zenmai/portableSpcPlayer/portableSpcPlayer_schematic.png

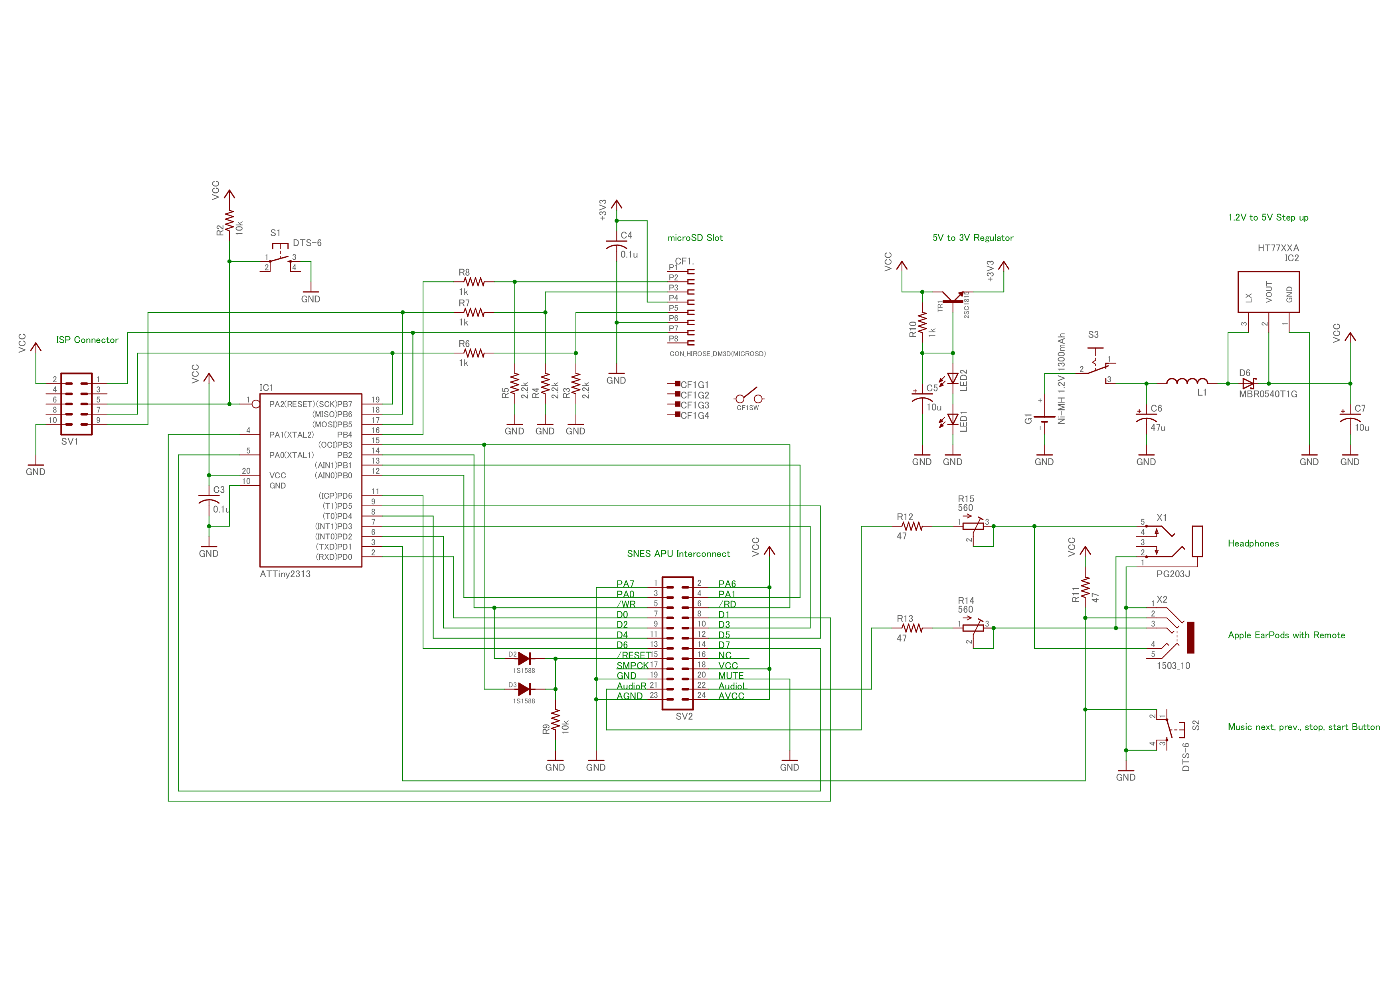
portableSpcPlayer_schematic.png
