zenmai/portableSpcPlayer/portableSpcPlayer.sch

## EAGLE design portableSpcPlayer.sch (2016-06-08)

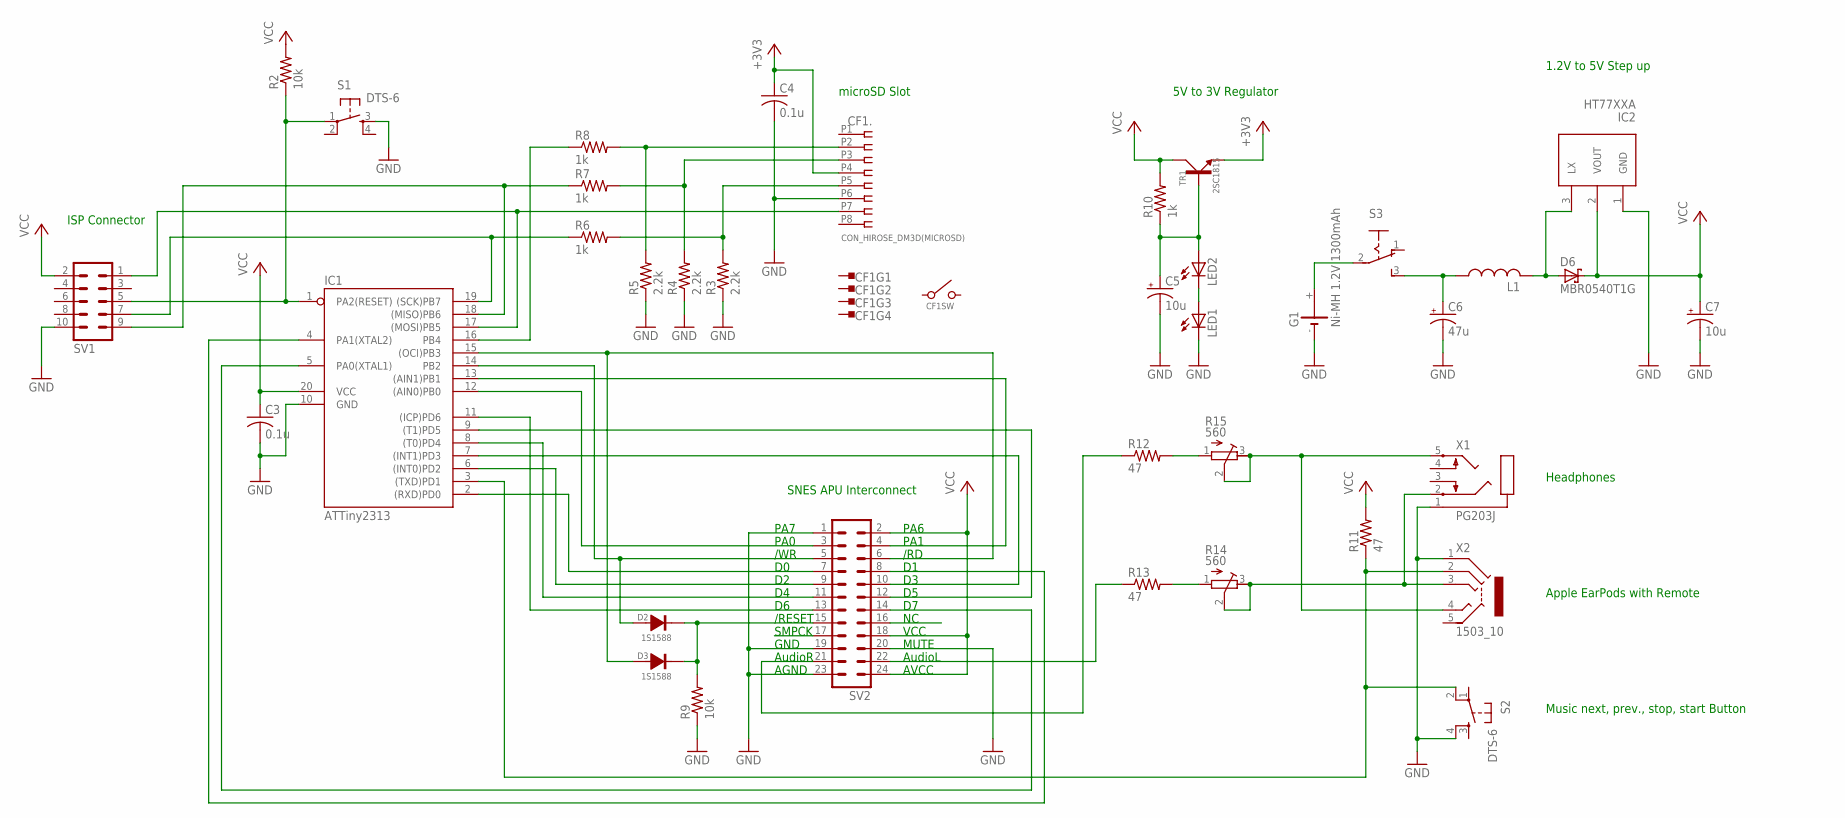
[picture p2: schematic portableSpcPlayer.sch]

Parts:
C3, C4: 0.1u; C050-024X044
C5, C7: 10u; E5-5
C6: 47u; E5-5
CF1: CON_HIROSE_DM3D(MICROSD); HIROSE_DM3D(MICRO-SD)
D2, D3: 1S1588; DIODE-D-5
D6: MBR0540T1G; DO41-7.6
G1: Ni-MH 1.2V 1300mAh; CRAA
IC1: ATTiny2313; DIL20
IC2: HT77XXA; TO92-N
L1: L-US0204/7; 0204/7
LED1, LED2: LED3MM
R2, R9: 10k; 0204/5
R3, R4, R5: 2.2k; 0204/5
R6, R7, R8, R10: 1k; 0204/5
R11, R12, R13: 47; 0204/5
R14, R15: 560; RTRIM4G/J
S1, S2: DTS-6
S3: 255SB
SV1: MA05-2
SV2: MA12-2
TR1: 2SC1815; TO92-
X1: PG203J
X2: 1503_10

Connections:
+3V3: C4.1, CF1.P4 (4), TR1.3
GND: C3.2, C4.2, C5.-, C6.-, C7.-, CF1.P6 (6), G1.-, IC1.10 (GND), IC2.1 (GND), LED1.K (C), R3.1, R4.1, R5.1, R9.1, S1.3, S2.4, SV1.10, SV2.1, SV2.19, SV2.20, SV2.23, X1.1, X2.1
unnamed: IC1.1 (PA2(RESET)), R2.1, S1.1, SV1.5
unnamed: IC1.19 ((SCK)PB7), R6.1, SV1.7
unnamed: IC1.18 ((MISO)PB6), R7.1, SV1.9
unnamed: CF1.P7 (7), IC1.17 ((MOSI)PB5), SV1.1
unnamed: CF1.P2 (2), R5.2, R8.2
unnamed: IC1.16 (PB4), R8.1
unnamed: CF1.P3 (3), R4.2, R7.2
unnamed: CF1.P5 (5), R3.2, R6.2
unnamed: IC1.12 ((AIN0)PB0), SV2.3
unnamed: D2.P$1, D3.P$1, R9.2, SV2.15
unnamed: D2.P$2, IC1.14 (PB2), SV2.5
unnamed: D3.P$2, IC1.15 ((OCI)PB3), SV2.6
unnamed: IC1.13 ((AIN1)PB1), SV2.4
unnamed: IC1.2 ((RXD)PD0), SV2.7
unnamed: IC1.6 ((INT0)PD2), SV2.9
unnamed: IC1.7 ((INT1)PD3), SV2.10
unnamed: IC1.8 ((T0)PD4), SV2.11
unnamed: IC1.9 ((T1)PD5), SV2.12
unnamed: IC1.11 ((ICP)PD6), SV2.13
unnamed: IC1.5 (PA0(XTAL1)), SV2.14
unnamed: R13.2, R14.1 (A)
unnamed: C5.+, LED2.A, R10.1, TR1.1
unnamed: D6.A, IC2.3 (LX), L1.2
unnamed: LED1.A, LED2.K (C)
unnamed: R12.1, SV2.21
unnamed: C6.+, L1.1, S3.3 (S)
unnamed: R13.1, SV2.22
unnamed: IC1.4 (PA1(XTAL2)), SV2.8
unnamed: G1.+, S3.2
unnamed: R12.2, R15.1 (A)
unnamed: R14.2 (S), R14.3 (E), X1.2, X2.3
unnamed: R15.2 (S), R15.3 (E), X1.5, X2.4
unnamed: IC1.3 ((TXD)PD1), R11.1, S2.2, X2.2
VCC: C3.1, C7.+, D6.C, IC1.20 (VCC), IC2.2 (VOUT), R2.2, R10.2, R11.2, SV1.2, SV2.2, SV2.18, SV2.24, TR1.2

Notes on the sheet:
ISP Connector
PA7
PA6
PA0
PA1
/WR
/RD
/RESET
SMPCK
VCC
GND
MUTE
AudioR
AudioL
AGND
AVCC
SNES APU Interconnect
microSD Slot
5V to 3V Regulator
1.2V to 5V Step up
Headphones
Apple EarPods with Remote
Music next, prev., stop, start Button
