zenmai/portableSpcPlayer/(commit log)

2016-06-08 schematic upload
2016-06-08 EagleCAD schematic file upload
    [portableSpcPlayer.sch]
2017-01-27 SDカードの初期化バグ修正ほか
    ・CMD55コマンド２回目以降の引数が0ではなくなるバグを修正
    ・CMD55コマンド後にウエイト追加のおまじない
    ・DSP初期化処理の改善
    ・空きメモリ確保のため、不要な処理を削除
    [main.c]
